kaktus85/MightyWatt/README.md

# MightyWatt
Resources for MightyWatt electronic load.
This repository contains all the available documentation and source files for MightyWatt electronic load project.
- a copy of this is also available on Google Drive: https://drive.google.com/folderview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
- an easy to read description of the various folders is here: http://kaktuscircuits.blogspot.cz/2015/03/mightywatt-resource-page.html
- MightyWatt can be purchased through Tindie: https://www.tindie.com/products/Kaktus/mightywatt-kit-70w-electronic-load-for-arduino/
