kaktus85/MightyWatt/Schematic-and-board/README.md

# Schematic and Board
- Cadsoft Eagle source files for the PCB of MightyWatt.
- A PNG schematic also included for a quick reference without having to install Eagle.
