kaktus85/MightyWatt/Acrylic-layered-case/README.md

# SVG Drawing
- A layered case that can be laser cut from 3mm acrylic sheets. 
- Numbers in parentheses indicate how many layers are needed for one case.
- Fits MightyWatt with Arduino Uno and Arduino Zero (M0/M0 Pro); however, you will need microUSB cable with a slim profile to fit into Arduino Zero.
