kaktus85/MightyWatt/Schematic-and-board/mightywatt.png

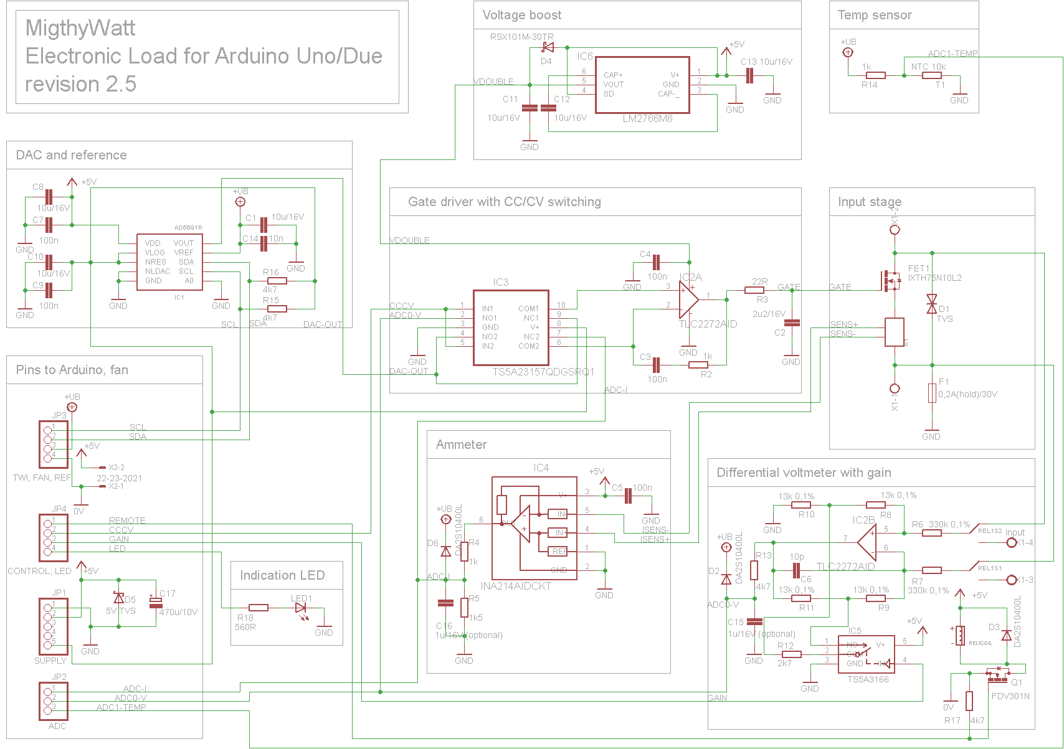
Schematic-and-board/mightywatt.png
