kaktus85/MightyWatt/Guides/README.md

# Guides
These are the how-tos for various aspects of MightyWatt
- **Detailed guide** is the basic document every user should read.
- **Case assembly instructions** will help you if you have the layered acrylic case.
- **Communication protocol description** is for advanced users who want to implement their own communication channel between a computer and MightyWatt.
- **Booster pack** has some ideas how to correctly use an additional power resistor to boost the power dissipation capability of MightyWatt.
