kaktus85/MightyWatt/Tests/mw_test_report_02_transient.xlsx

Sheet: device description
Test report on MightyWatt electronic load for Arduino
Transient testing
2016-09-21
Jakub Polonský (kaktus circuits)
MightyWatt
standard 30V/10A/70W unit with Arduino Uno
revision 2.5
manufactured 2016-08
standard terminals
firmware 2.5.9
control program 1.3.0.1
Power supply
Nitecore RCR123A 650mAh Li-Ion rechargeable battery
Oscilloscope
Rigol DS1052E
probe 10:1
Current shunt for oscilloscope
wirewound 0.15 Ω
Ambient conditions
22 °C

Sheet: Constant current
Current transient
0 A => 3 A | 1 ms
3 A => 0 A | 0.5 ms

Sheet: Constant voltage
Voltage transient
4 V => 3 V | 0.66 ms
3 V => 4 V | 0.44 ms
