kaktus85/MightyWatt/Tests/mw_test_report01.xlsx

Sheet: device description
Test report on MightyWatt electronic load for Arduino
2015-12-03
Jakub Polonský (kaktus circuits)
MightyWatt
standard 30V/10A/70W unit
revision 2.5
manufactured 2015-11
standard terminals
firmware 2.5.1
Power supply
PSD30/3C linear laboratory power supply
30V/3A
oscilloscope noise measurements: 2× Panasonic Eneloop Pro 1.2 V NiMH batteries in series
Ammeter
Multimeter Keysight 34461A
auto range, max 3A, 10 PLC integration
Oscilloscope
Rigol DS1052E
probe 1:1
Ambient conditions
21 °C

Sheet: Arduino Uno
Calibration
DAC | ADC | Actual I, A |  | IDAC_SLOPE | 10492.1088
40 | 28 | 0.1008 |  | IDAC_INTERCEPT | -1.558
320 | 308 | 0.81816
600 | 588 | 1.5355 |  | IADC_SLOPE | 10477.11868
880 | 868 | 2.2527 |  | IADC_INTERCEPT | 30.30934652
1160 | 1150 | 2.9697
Physical ADC LSB | 10.23 | mA
Oversampled ADC LSB | 2.56 | mA
Physical DAC LSB | 2.56 | mA
Measurement
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
