kaktus85/MightyWatt/Calibration-aid/calibration.xlsx

Sheet: Part1 – Constant current
DAC | ADC | Actual I, A | IDAC_SLOPE | 10122.71543
23 | 8 | 0.0444 | IDAC_INTERCEPT | -18.66820536
223 | 204 | 0.5306
423 | 403 | 1.0243 | IADC_SLOPE | 10133.54168
623 | 602 | 1.5156 | IADC_INTERCEPT | 25.98444079
823 | 805 | 2.01915
1023 | 1000 | 2.4995
1223 | 1208 | 3.0134

Sheet: Part 2 – Voltmeter
No gain |  | Gain |  | VADC0_SLOPE | 31614.26073
ADC | Actual voltage, V | ADC | Actual voltage, V | VADC0_INTERCEPT | 58.21537705
3920 | 30.3320 | 3972 | 5.2833
3512 | 27.1630 | 3536 | 4.6996 | VADC1_SLOPE | 5444.646947
3123 | 24.1670 | 3084 | 4.0934 | VADC1_INTERCEPT | -1.810887975
2720 | 21.0450 | 2675 | 3.5513
2340 | 18.1030 | 2254 | 2.9940
1936 | 14.9843 | 1903 | 2.5251
1568 | 12.1480 | 1536 | 2.0388
1172 | 9.1243 | 1144 | 1.5188
656 | 5.1331 | 764 | 1.0160
 |  | 423 | 0.5628
 |  | 60 | 0.0780
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
