kaktus85/MightyWatt/Tests/README.md

# Tests
This folder contains test I have performed with MightyWatt. It can serve as a reference of what sort of accuracy you can expect from MightyWatt.
