kaktus85/MightyWatt/Schematic-and-board/mightywatt.brd

## EAGLE design Schematic-and-board/mightywatt.brd (2016-06-30)

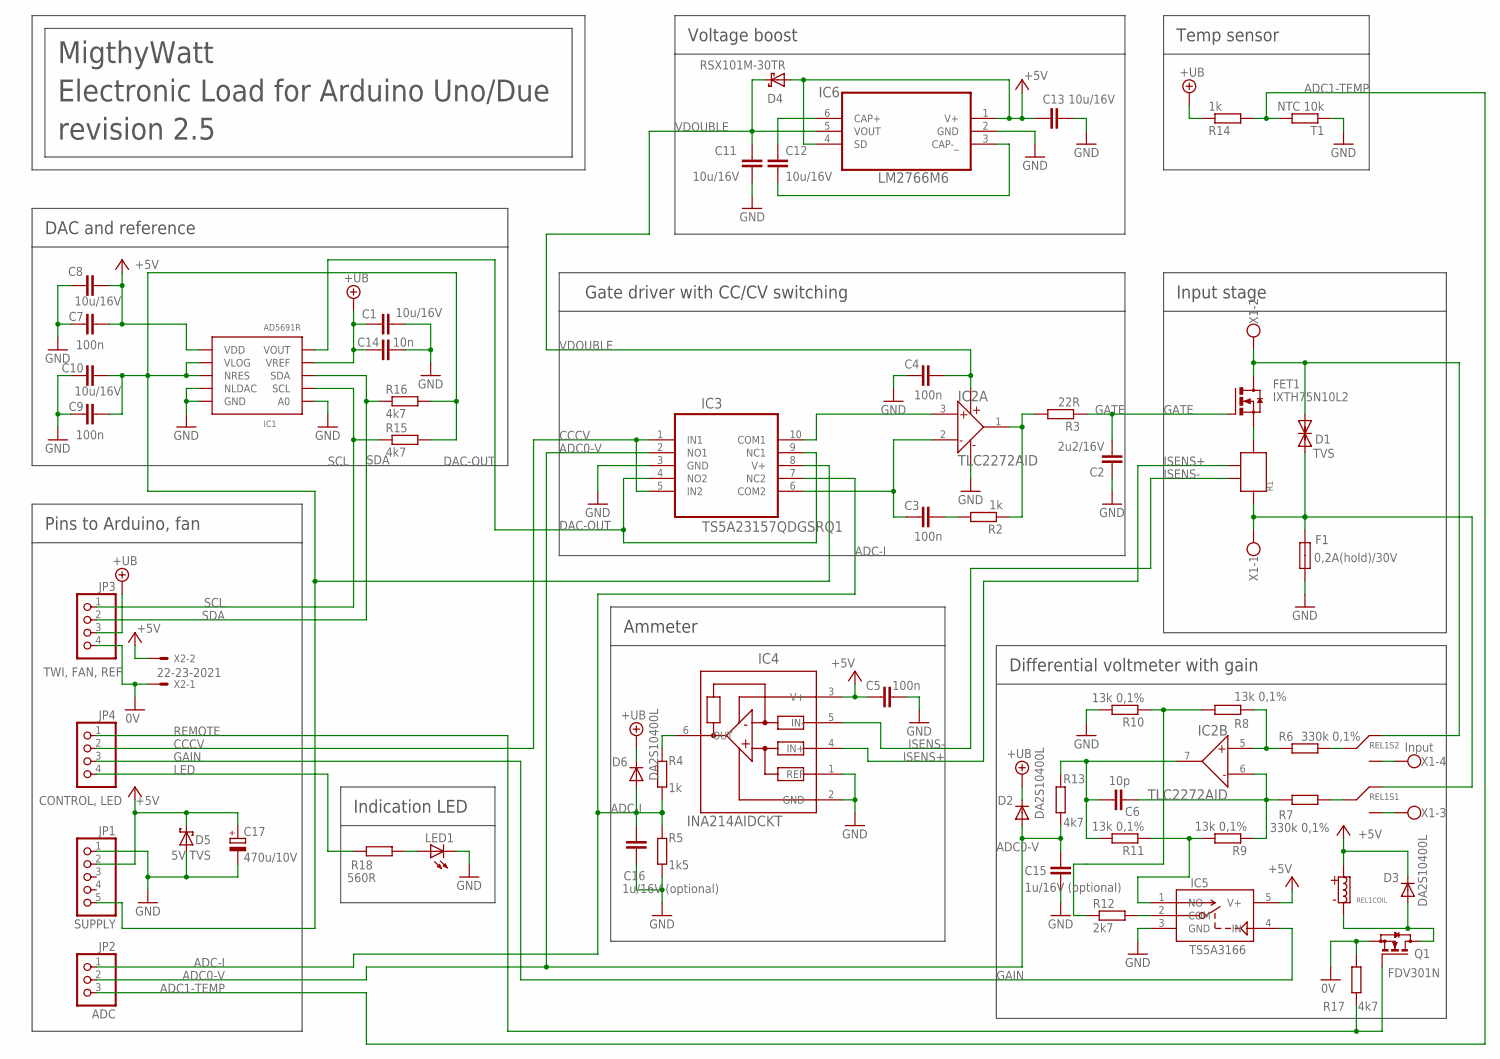
[picture p10: schematic mightywatt.sch]

Parts:
C1, C8, C10, C11, C12, C13: 10u/16V; C1206
C2: 2u2/16V; C1206
C3, C4, C5, C7, C9: 100n; C0603
C6: 10p; C0603
C14: 10n; C0805
C15, C16: 1u/16V (optional); C0603
C17: 470u/10V; SMC_E
D1: TVS; SMC
D2, D3, D6: DA2S10400L; SOD523
D4: RSX101M-30TR; SOD123
D5: 5V TVS; SMB
F1: 0,2A(hold)/30V; R1812
FET1: IXTH75N10L2; TO-247AD-H
IC1: AD5691RAD5691R; SOP50P490X110-10N
IC2: TLC2272AID; SOIC127P600X175-8N
IC3: TS5A23157QDGSRQ1; SOP50P490X110-10N
IC4: INA214AIDCKT; SOT65P210X110-6N; MPN INA214BIDCKT
IC5: TS5A3166; SC70-5
IC6: LM2766M6; SOT95P285X122-6N
JP1: SUPPLY; 1X05
JP2: ADC; 1X03
JP3: TWI, FAN, REF; 1X04
JP4: CONTROL, LED; 1X04
LED1: LEDCHIP-LED0805; CHIP-LED0805
Q1: BSS123; SOT23; PARTNAME FDV301N
R1: WSL3637; POWER-R-4TERM
R2, R4, R14: 1k; R0603
R3: 22R; R0603
R5: 1k5; R0603
R6, R7: 330k 0,1%; R0603
R8, R9, R10, R11: 13k 0,1%; R0603
R12: 2k7; R0603
R13, R15, R16, R17: 4k7; R0603
R18: 560R; R0603
REL1: IM03NS; IM03NS-NARROW-RELAY
T1: NTC 10k; R0402
X1: Input; W237-4
X2: 22-23-2021

Connections:
0V: JP3.4, Q1.2 (S), R17.1, X2.1
+5V: C5.1, C7.2, C8.2, C13.1, C17.+, D3.C, D4.A, D5.C, IC1.1 (VDD), IC4.3 (V+), IC5.5 (V+), IC6.1 (V+), IC6.4 (SD), JP1.2, REL1.P$1 (C+), X2.2
+UB: C1.1, C14.1, D2.C, D6.C, IC1.9 (VREF), JP3.3, R14.1
ADC0-V: C15.2, D2.A, IC3.2 (NO1), JP2.2, R13.1
ADC1-TEMP: JP2.3, R14.2, T1.2
ADC-I: C16.2, D6.A, IC3.7 (NC2), JP2.1, R4.2, R5.1
CCCV: IC3.1 (IN1), IC3.5 (IN2), JP4.2
DAC-OUT: IC1.10 (VOUT), IC3.4 (NO2), IC3.9 (NC1)
GAIN: IC5.4 (IN), JP4.3
GATE: C2.2, FET1.G, R3.1
GND: C1.2, C2.1, C4.1, C5.2, C7.1, C8.1, C9.1, C10.1, C11.2, C13.2, C14.2, C15.1, C16.1, C17.-, D5.A, F1.2, IC1.4 (NLDAC), IC1.5 (GND), IC1.6 (A0), IC2.4 (V-/GND), IC3.3 (GND), IC4.1 (REF), IC4.2 (GND), IC5.3 (GND), IC6.2 (GND), JP1.1, LED1.C, R5.2, R10.2, T1.1
IOREF: C9.2, C10.2, IC1.2 (VLOG), IC1.3 (NRES), IC3.8 (V+), JP1.5, R15.2, R16.2
ISENS+: IC4.4 (IN+), R1.SENSE2
ISENS-: IC4.5 (IN-), R1.SENSE1
LED: JP4.4, R18.1
unnamed: IC2.5 (IN+), R6.2, R8.1
unnamed: D1.A, F1.1, R1.POWER1, REL1.P$2 (NC), X1.1
unnamed: C6.1, IC2.6 (IN-), R7.2, R9.1
unnamed: D1.C, FET1.D, REL1.P$7 (NC), X1.2
unnamed: C12.1, IC6.6 (CAP+)
unnamed: C12.2, IC6.3 (CAP-_)
unnamed: R8.2, R10.1, R12.1
unnamed: REL1.P$4 (NO), X1.3
unnamed: REL1.P$5 (NO), X1.4
unnamed: FET1.S, R1.POWER2
unnamed: IC2.1 (OUT), R2.1, R3.2
unnamed: R6.1, REL1.P$6 (COM)
unnamed: IC5.2 (COM), R12.2
unnamed: IC5.1 (NO), R9.2, R11.1
unnamed: LED1.A, R18.2
unnamed: R7.1, REL1.P$3 (COM)
unnamed: C3.2, R2.2
unnamed: C3.1, IC2.2 (IN-), IC3.6 (COM2)
unnamed: C6.2, IC2.7 (OUT), R11.2, R13.2
unnamed: IC2.3 (IN+), IC3.10 (COM1)
unnamed: D3.A, Q1.3 (D), REL1.P$8 (C-)
R3: IC4.6 (OUT), R4.1
REMOTE: JP4.1, Q1.1 (G), R17.2
SCL: IC1.7 (SCL), JP3.1, R15.1
SDA: IC1.8 (SDA), JP3.2, R16.1
VDOUBLE: C4.2, C11.1, D4.C, IC2.8 (V+), IC6.5 (VOUT)

Notes on the sheet:
Voltage boost
DAC and reference
Temp sensor
Pins to Arduino, fan
Input stage
Ammeter
Differential voltmeter with gain
Gate driver with CC/CV switching
MigthyWatt Electronic Load for Arduino Uno/Due revision 2.5
Indication LED

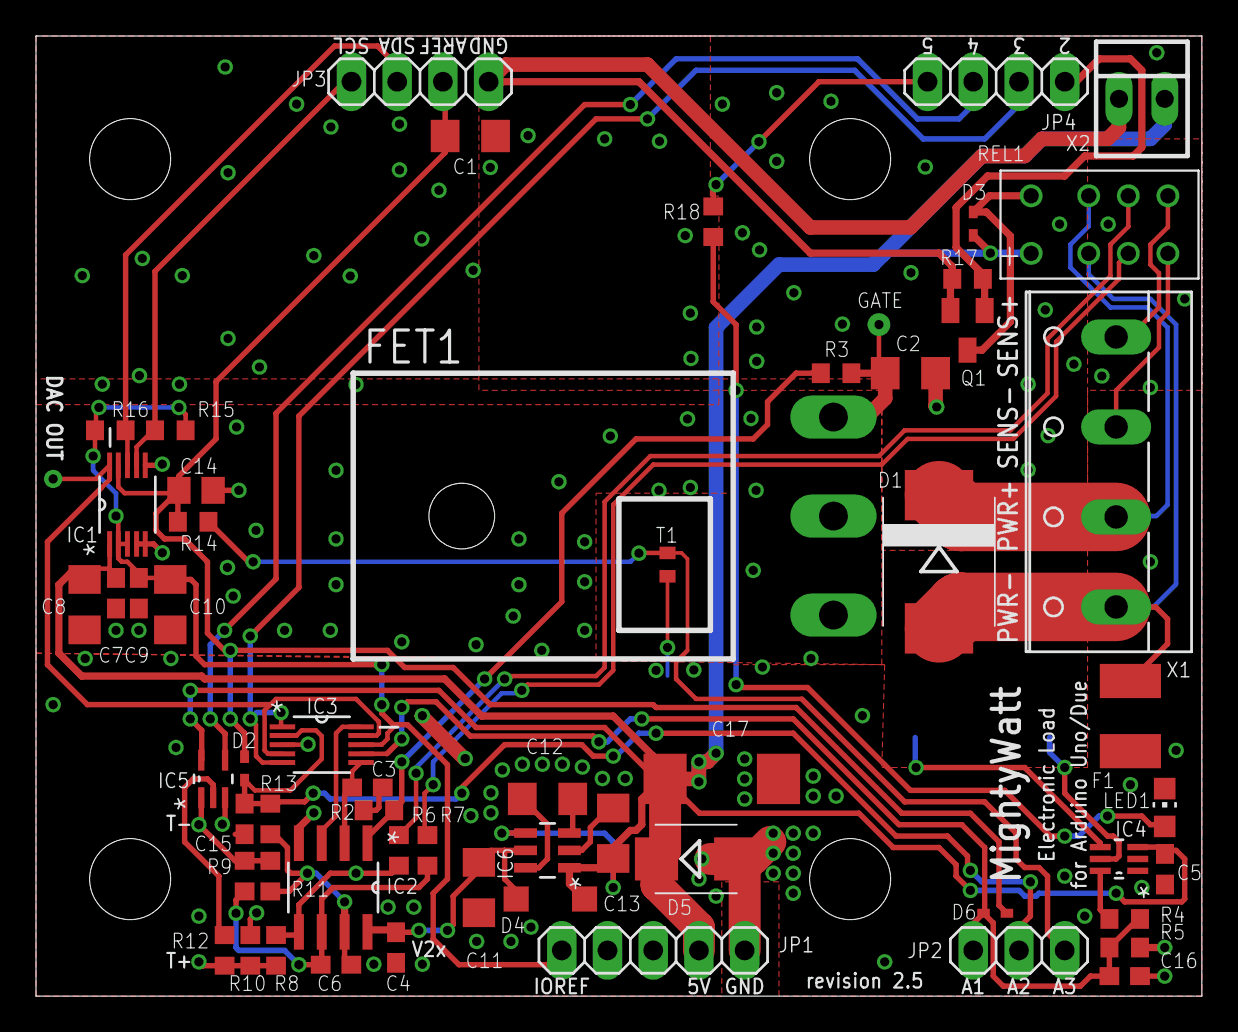
[picture p11: board mightywatt.brd from above]

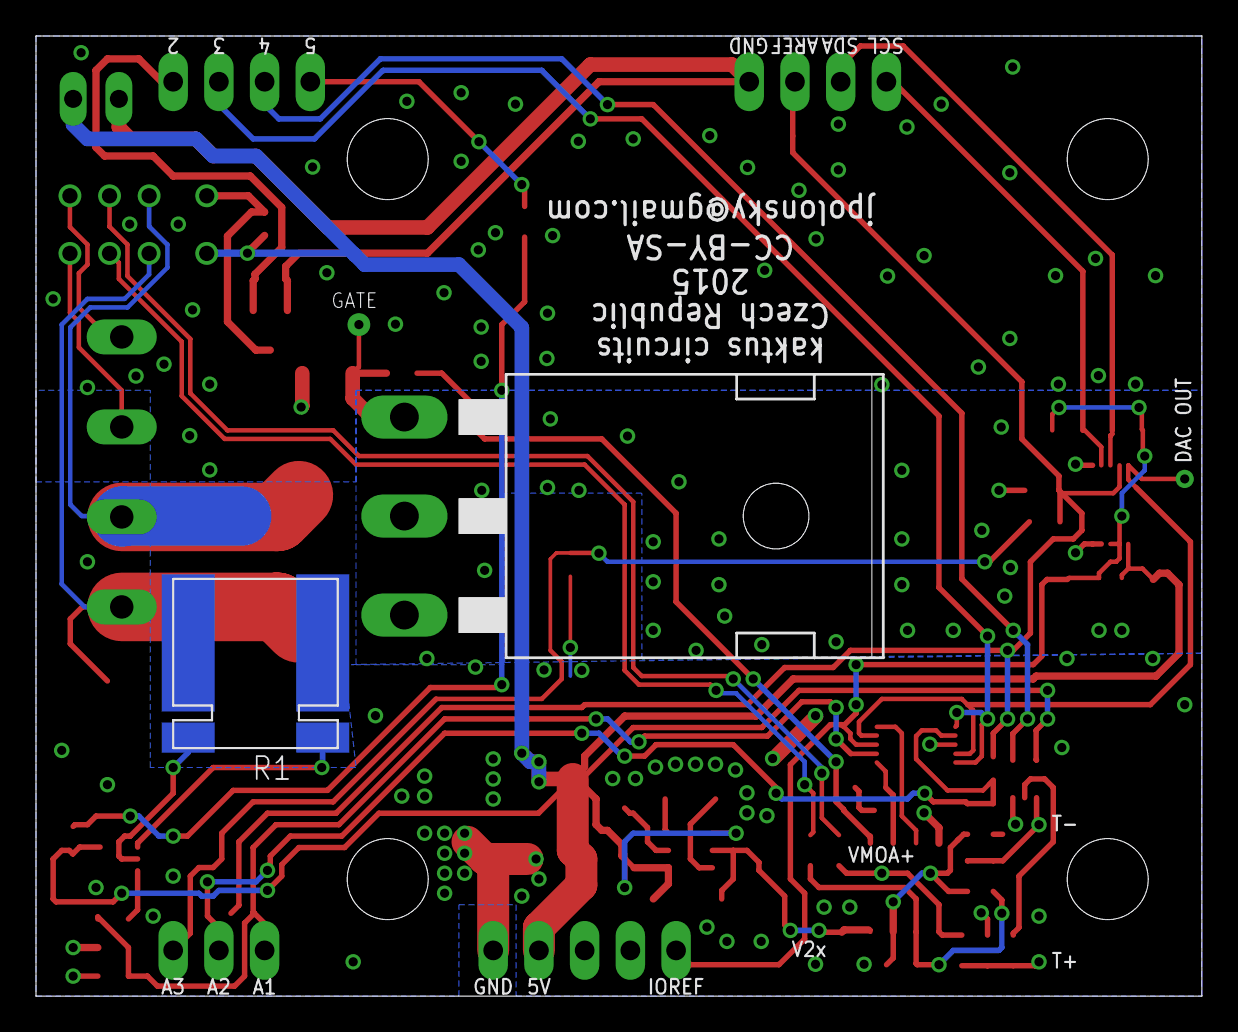
[picture p12: board mightywatt.brd from below]

Board: 2 copper layers, 64.8 x 53.3 mm, 59 parts (2 on the bottom side), 41 nets.
