kaktus85/MightyWatt/(commit log)

2016-06-29 Case drawings first upload
2016-06-29 Acrylic layered case
2016-06-29 Case drawings
2016-06-30 Sketch for the 4A version
    Sketch with approximate calibration values for the 4A version
    Please, calibrate with your Arduino (or whatever ADC you are using)
2016-06-30 Sketch for the 10A version
    Sketch with approximate calibration values for the 10A version
    Please, calibrate with your Arduino (or whatever ADC you're using)
2016-06-30 Sketch for the 20A version
    Sketch with approximate calibration values for the 20A version
    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
2016-06-30 Sketch for calibration
    Works with all versions of the current range
2016-06-30 PDF bill of materials
2016-06-30 Excel calibration aid
    Excel file to calculate and keep calibration values obtained from calibration sketch and external voltmeter/ammeter
    [calibration_fw2.5.4.xlsx]
2016-06-30 File rename and upload
    [calibration.xlsx]
2016-07-01 MPPT algorithm change
    Added automatic current decrease on zero voltage. If the two previous
    actions were the same, the current change will be steeper (2 LSB instead
    of 1 LSB).
2016-08-20 Compatibility with Arduino Zero
2016-08-20 Updated LED current info
2016-08-23 Increased IADC_INTERCEPT integer size
    IADC_INTERCEPT is now 16-bit signed integer to accomodate Arduinos with
    larger offset.
2016-08-24 Automatic reset of DAC
    Added reset of DAC to the initialization routine
    [mightywatt_fw-10A.ino, mightywatt_fw-20A.ino, mightywatt_fw-4A.ino]
2016-08-24 Automatic reset of DAC
    Added automatic reset of DAC to initialization routine
    [mightywatt_calibration.ino]
2016-09-21 Added report on transient testing
    [mw_test_report_02_transient.xlsx]
2016-12-04 Better fit with Arduino Zero
2017-02-11 Added Integrator and statistics toolbox
    Integrators and statistics toolbox displays statistical information on
    measured values and can integrate charge and energy
