kaktus85/MightyWatt/(notices)

Notices in the files:
Schematic-and-board/mightywatt.brd:
CC-BY-SA
